Netsrot1150/esp32-outlander-bms/hw/fab/render_bottom.png

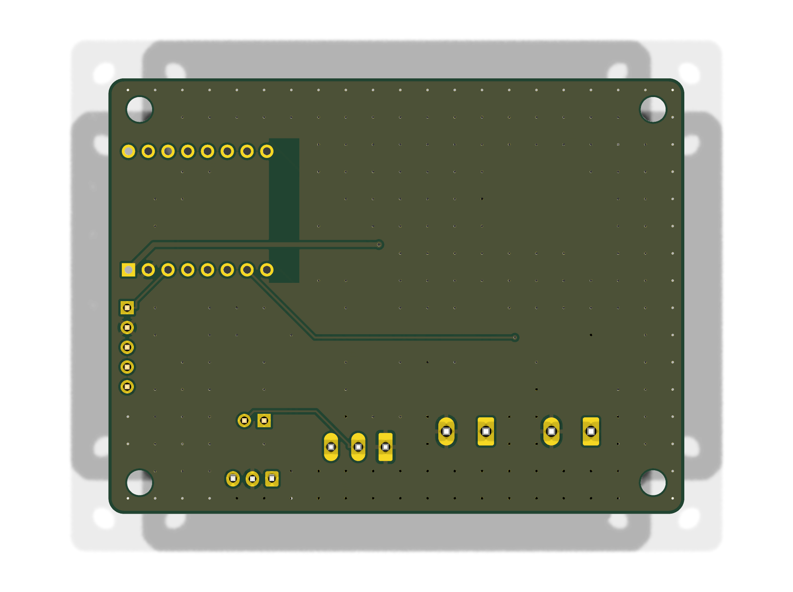
hw/fab/render_bottom.png
