Netsrot1150/esp32-outlander-bms/hw/fab/bms-kort-bom.csv

Comment | Designator | Footprint | LCSC
SN65HVD230 | U3 | SOIC-8_3.9x4.9mm_P1.27mm | C12084
10u 50V | C1 | C_1206_3216Metric | C13585
L78L33ACUTR | U2 | SOT-89-3 | C14170
NUP2105L | D4 | SOT-23 | C14486
100n | C2,C4,C8,C11,C12,C13 | C_0603_1608Metric | C14663
AO3401A | Q1,Q2 | SOT-23 | C15127
1u | C9,C10 | C_0603_1608Metric | C15849
2A 30V | F1 | Fuse_1812_4532Metric | C18198342
1k | R9,R12,R16 | R_0603_1608Metric | C21190
120 | R13 | R_0603_1608Metric | C22787
1M | R1,R5,R14 | R_0603_1608Metric | C22935
BMS | D3 | LED_0805_2012Metric | C2297
2M | R2 | R_0603_1608Metric | C22976
4.7k | R11 | R_0603_1608Metric | C23162
470k | R3 | R_0603_1608Metric | C23178
68k | R8 | R_0603_1608Metric | C23231
100k | R10 | R_0603_1608Metric | C25803
120k | R4,R6 | R_0603_1608Metric | C25808
200k | R15 | R_0603_1608Metric | C25811
47k | R7 | R_0603_1608Metric | C25819
SMBJ18A | D1 | D_SMB | C353379
22u 25V | C5,C6,C7 | C_0805_2012Metric | C45783
2.2u 50V | C3 | C_1206_3216Metric | C50254
TPS560430XDBVR | U1 | SOT-23-6 | C524782
22u | L1 | L_Sunlord_SWPA5040S | C68434
2N7002 | Q3 | SOT-23 | C8545
B5819W | D2,D5 | D_SOD-123 | C8598
