Netsrot1150/esp32-outlander-bms/hw/fab/handlodning.csv

Ref | Värde | LCSC | Del | Not
J1 | 12V IN | C441204 | KF2EDGR-5.08-2P | Plugg: KF2EDGK-5.08-2P (C440880)
J2 | CMU 12V | C441204 | KF2EDGR-5.08-2P | Plugg: KF2EDGK-5.08-2P (C440880)
J3 | CAN | C5160226 | 15EDGRC-3.5-03P | Plugg: 15EDGK-3.5-03P (C5188250)
J4 | WCS1700 | C144394 | B3B-XH-A | 1 = 3,3 V, 2 = GND, 3 = AO
JP1 | 120R | C492401 | PZ254V-11-02P | Bygel på = 120 Ω avslutning
U4 | ESP32-C3 SuperMini | C27438 | 2 st hylslist 1x8 2,54 mm 8,5 mm | Hylslisten (2 st C27438) löds på kortet. Ta bort röda ström-LED:en på SuperMini
