Netsrot1150/esp32-outlander-bms/hw/fab/bms-kort-schema.pdf

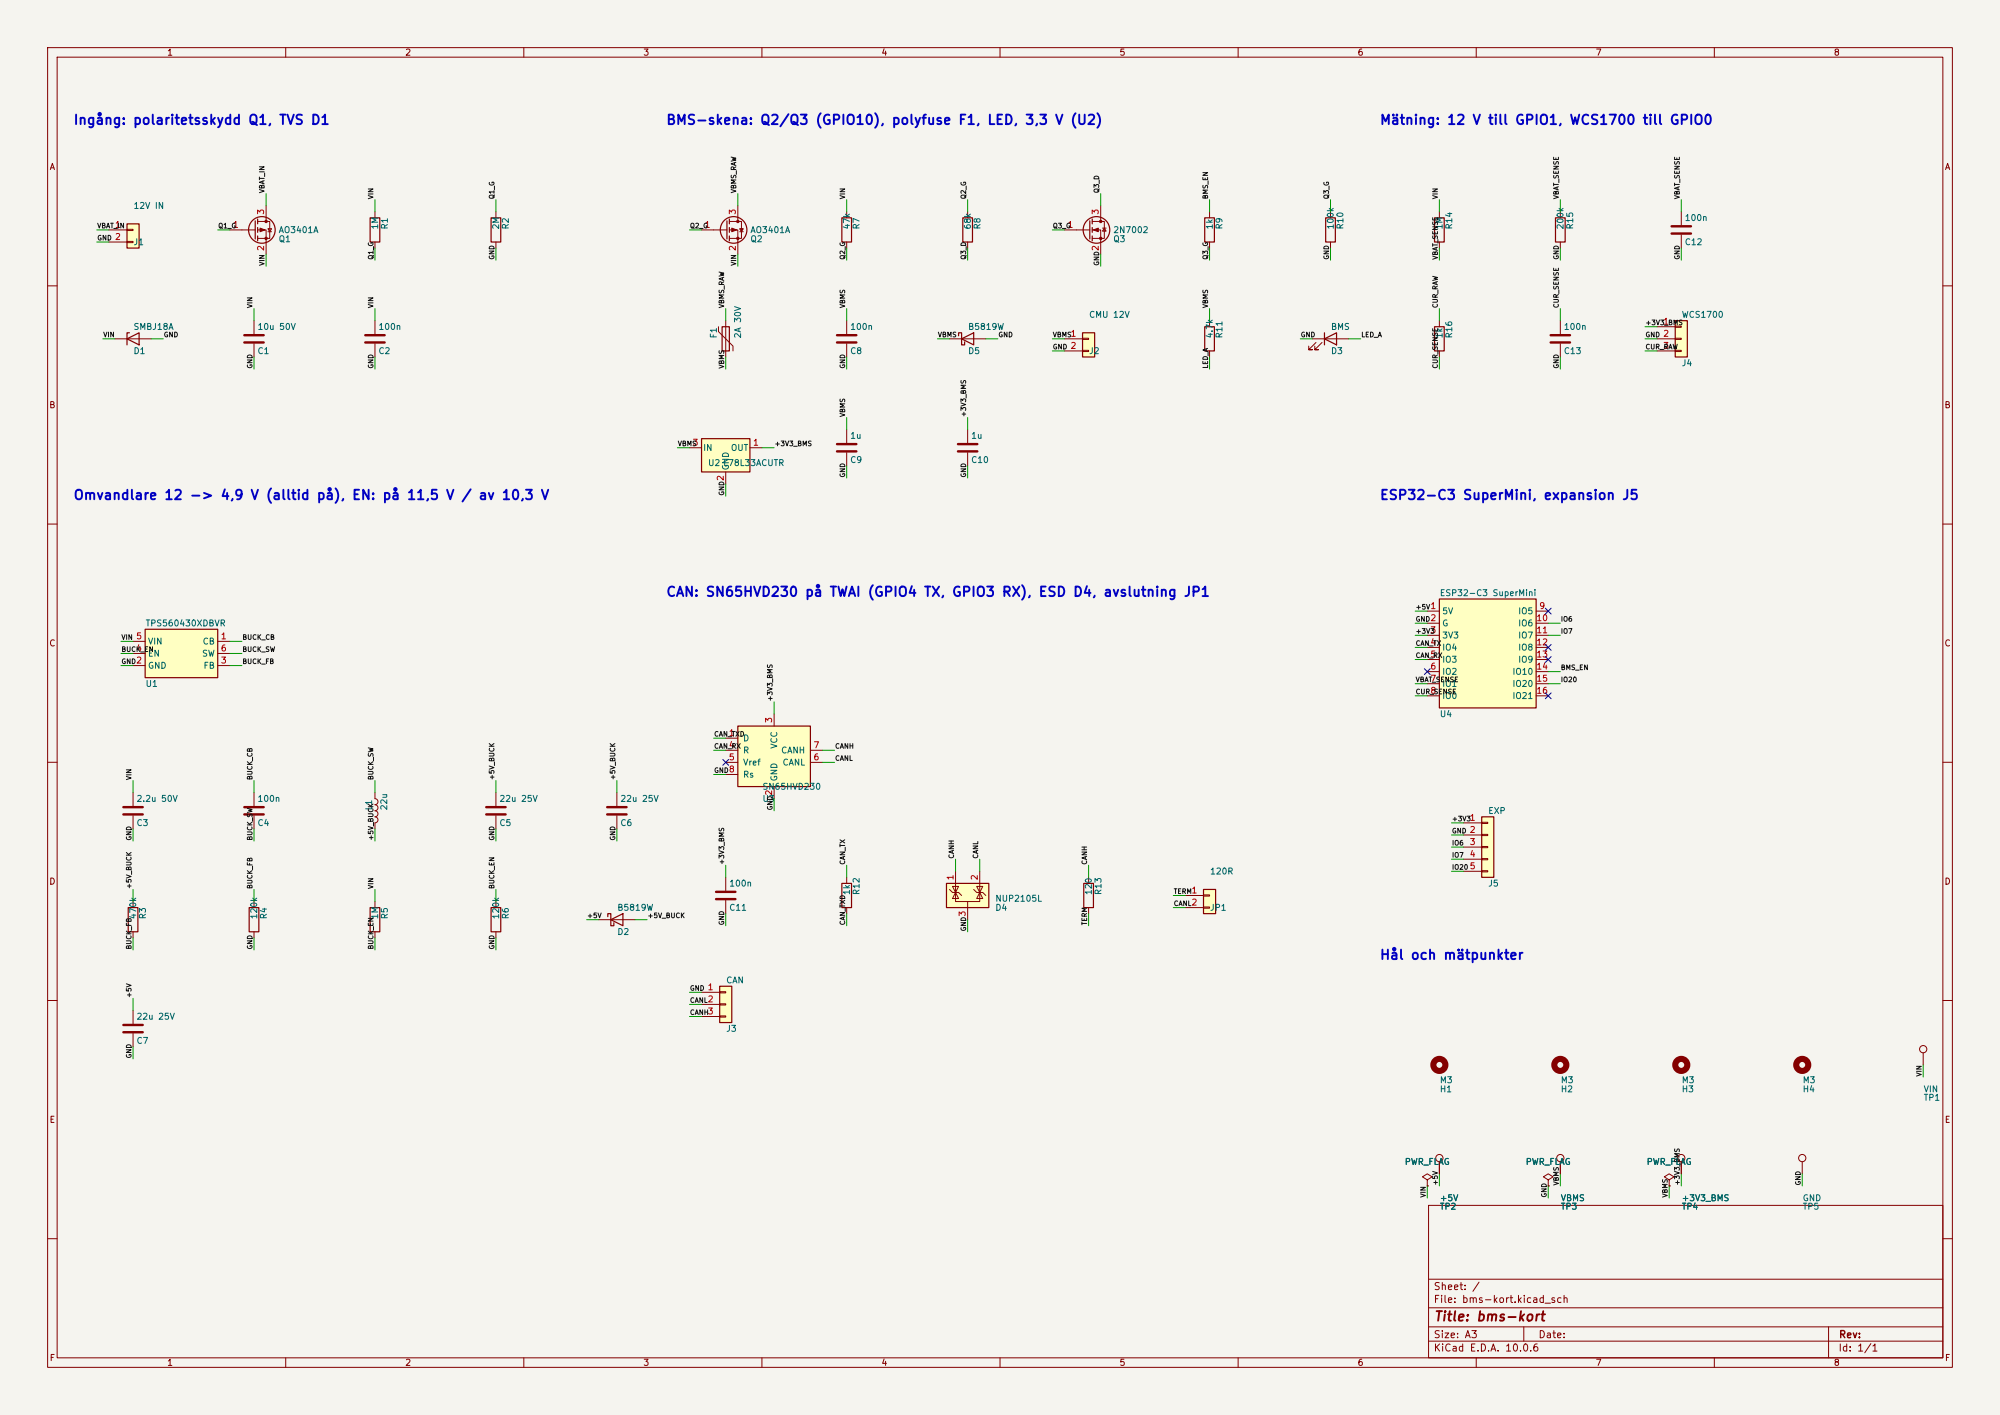
[picture p4: page 1]

Omvandlare 12 -> 4,9 V (alltid på), EN: på 11,5 V / av 10,3 V
BUCK_SW GND

CAN: SN65HVD230 på TWAI (GPIO4 TX, GPIO3 RX), ESD D4, avslutning JP1

Size: A3 | Rev: | F Date:
KiCad E.D.A. 10.0.6 | Id: 1/1
