Netsrot1150/esp32-outlander-bms/hw/bms-kort/bms-kort.kicad_pcb

## KiCad design hw/bms-kort/bms-kort.kicad_pcb (2026-10-15)

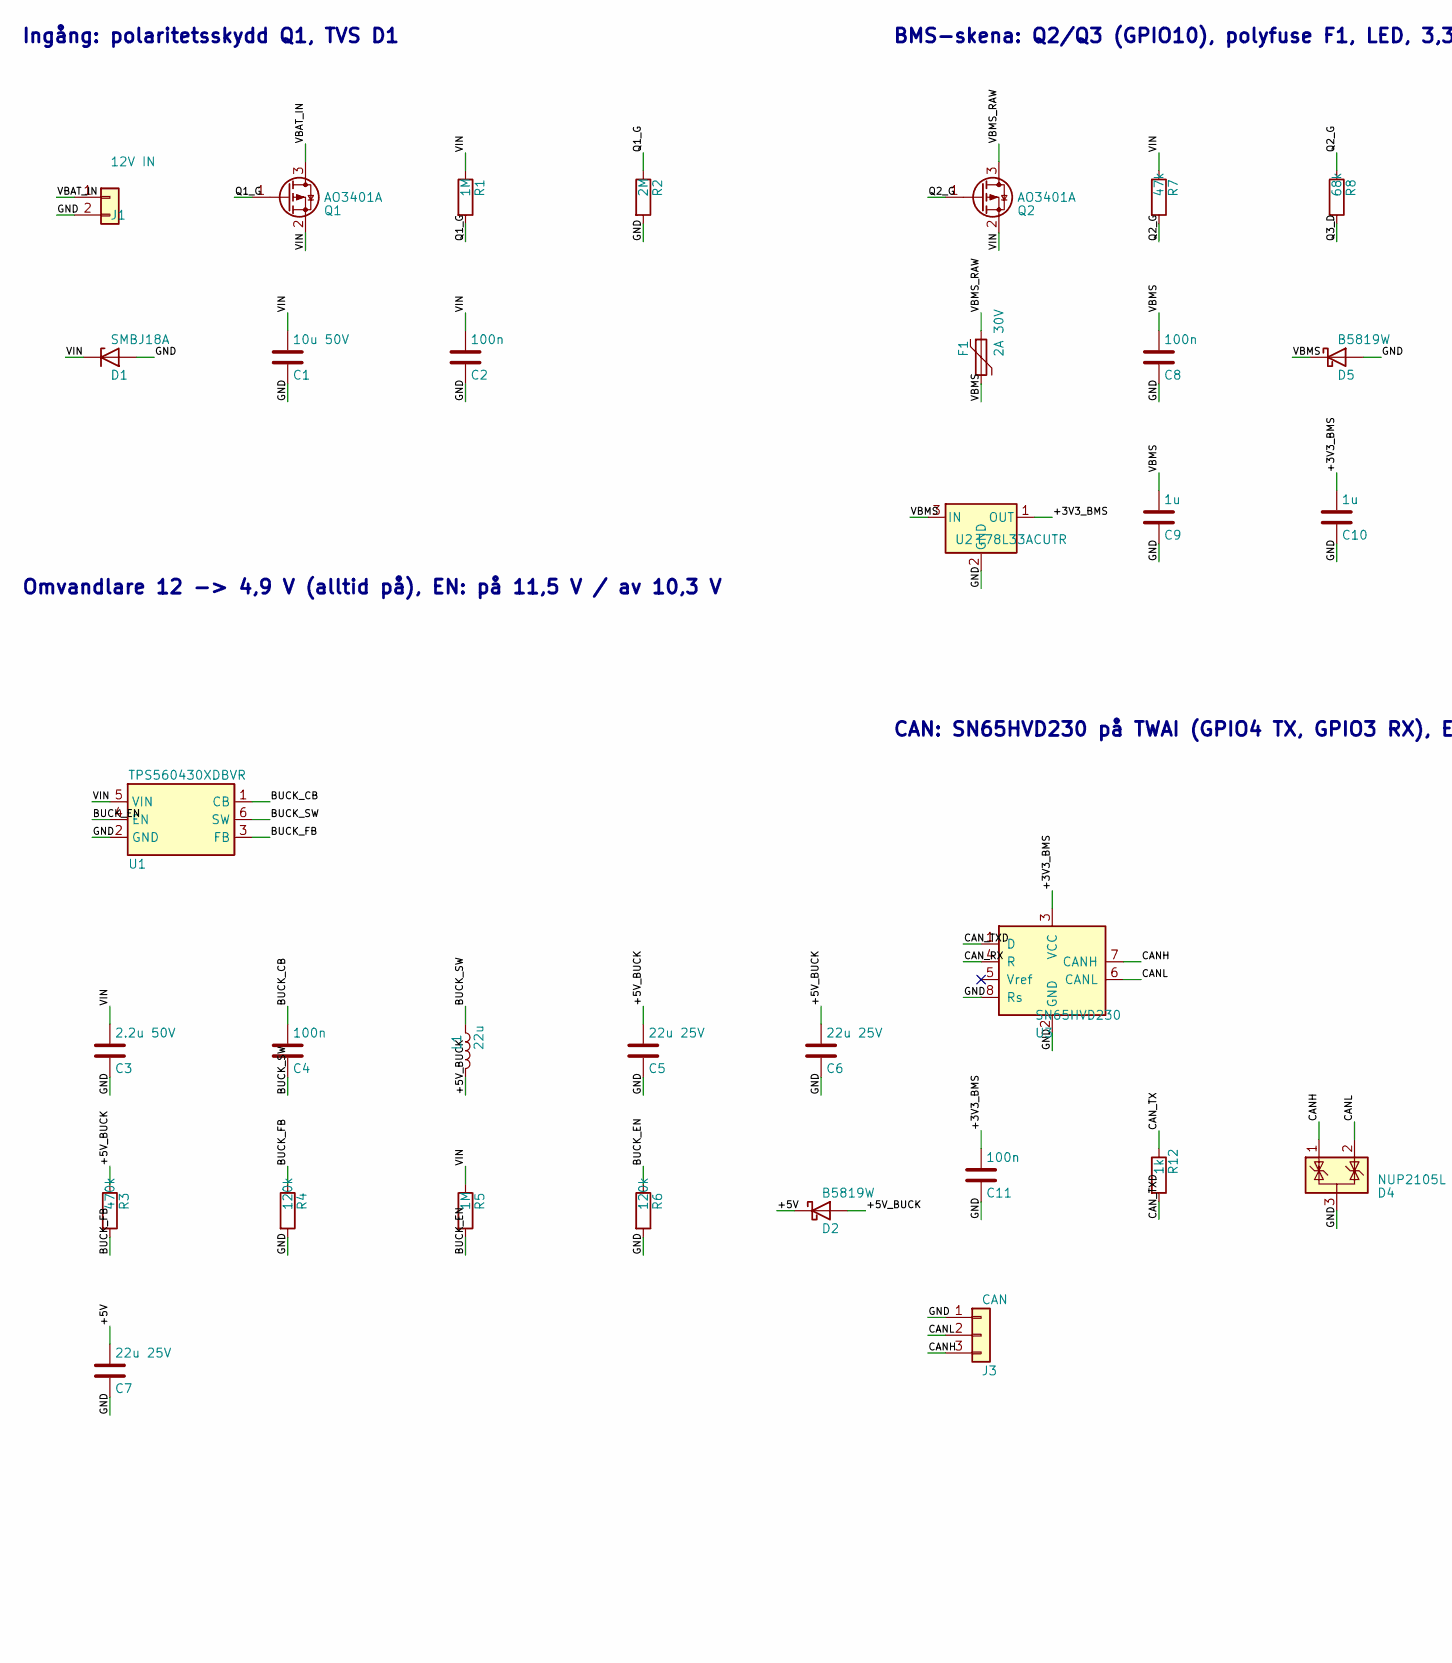
[picture p5: schematic bms-kort.kicad_sch, part in row 1, column 1]

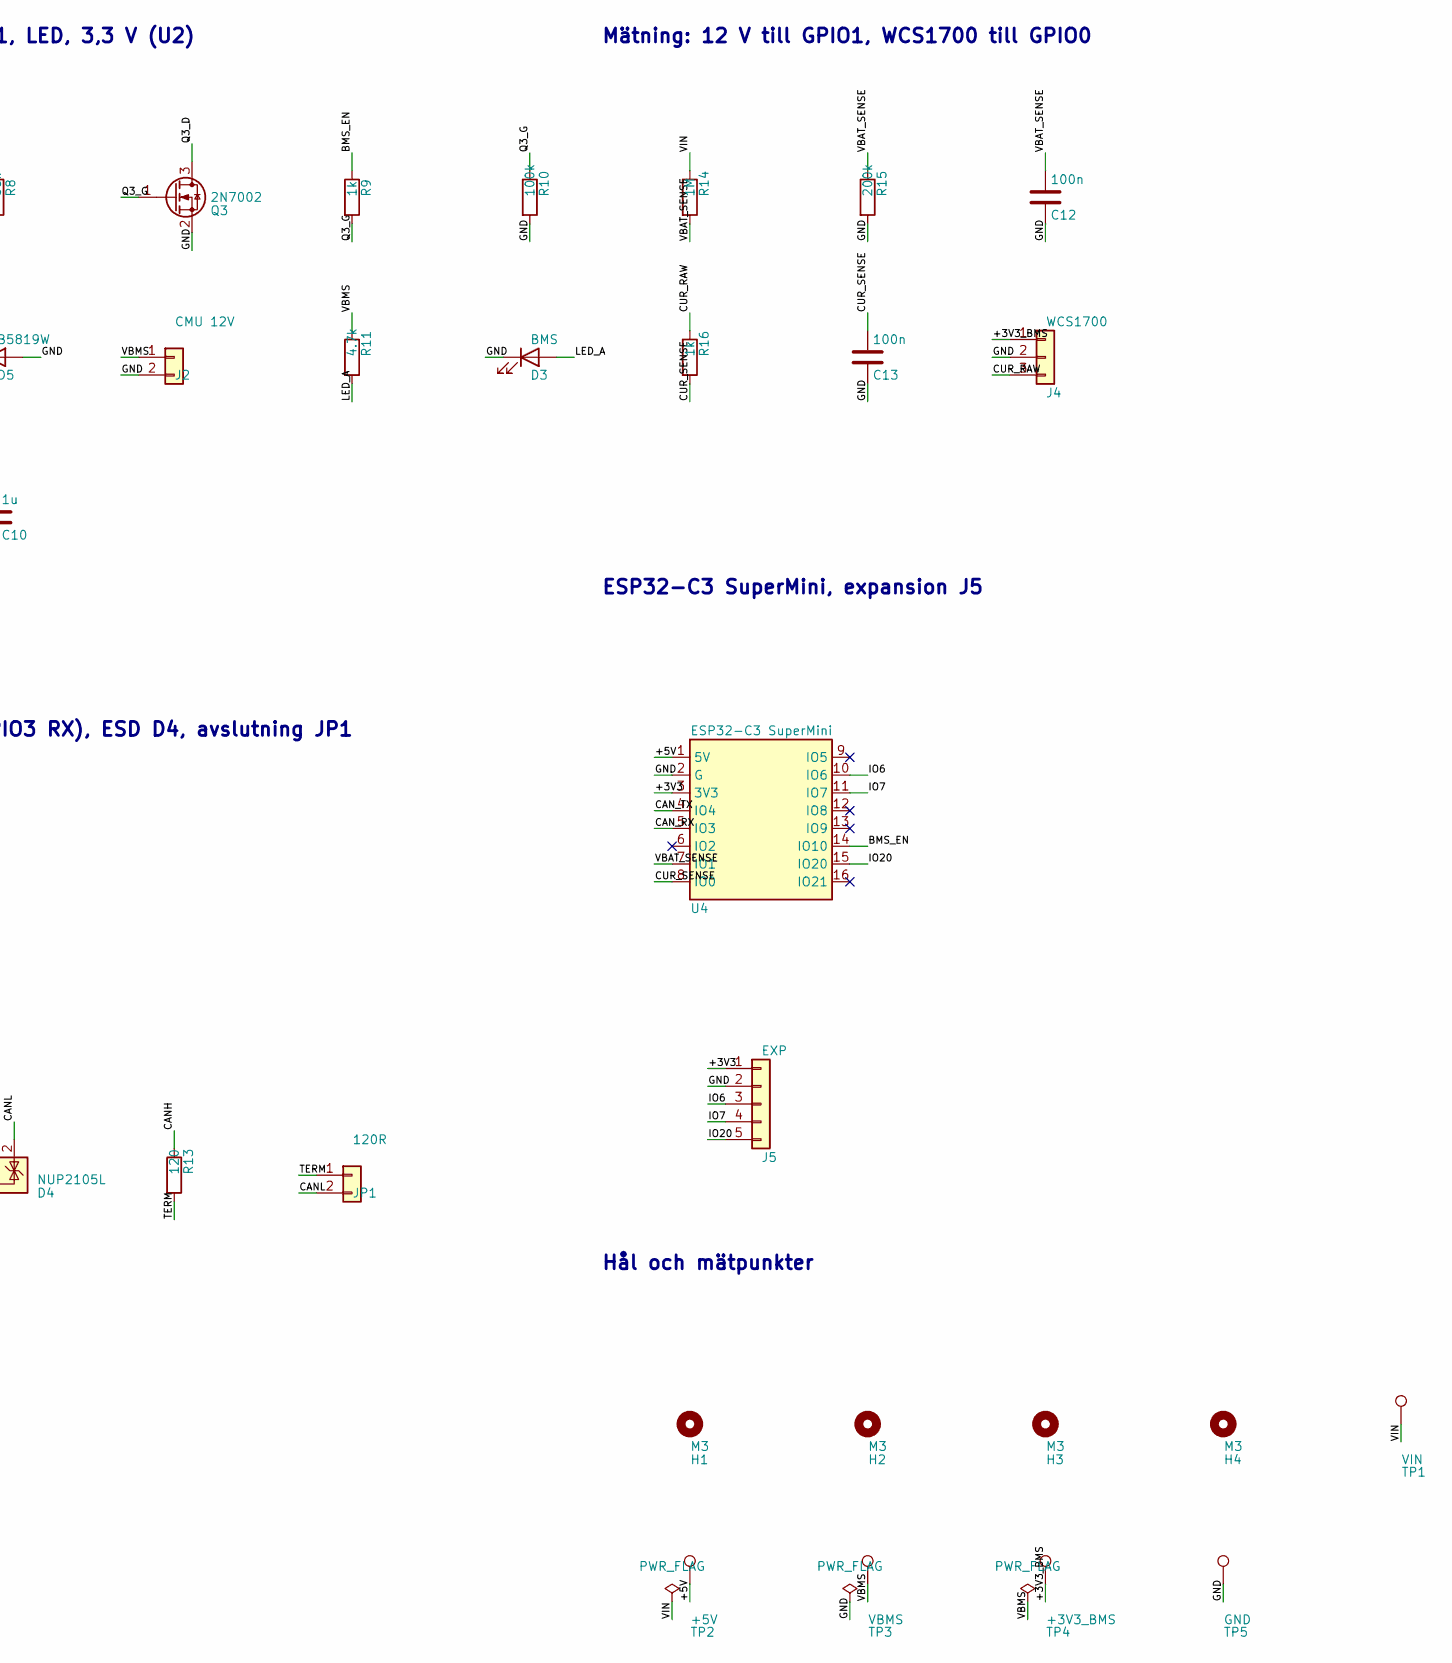
[picture p6: schematic bms-kort.kicad_sch, part in row 1, column 2]

Parts:
C1: 10u 50V; C_1206_3216Metric; LCSC C13585
C2, C4, C8, C11, C12, C13: 100n; C_0603_1608Metric; LCSC C14663
C3: 2.2u 50V; C_1206_3216Metric; LCSC C50254
C5, C6, C7: 22u 25V; C_0805_2012Metric; LCSC C45783
C9, C10: 1u; C_0603_1608Metric; LCSC C15849
D1: SMBJ18A; D_SMB; LCSC C353379
D2, D5: B5819W; D_SOD-123; LCSC C8598
D3: BMS; LED_0805_2012Metric; LCSC C2297
D4: NUP2105L; SOT-23; LCSC C14486
F1: 2A 30V; Fuse_1812_4532Metric; LCSC C18198342
H1, H2, H3, H4: M3; MountingHole_3.2mm_M3
J1: 12V IN; PhoenixContact_MSTBA_2,5_2-G-5,08_1x02_P5.08mm_Horizontal; LCSC C441204
J2: CMU 12V; PhoenixContact_MSTBA_2,5_2-G-5,08_1x02_P5.08mm_Horizontal; LCSC C441204
J3: CAN; PhoenixContact_MC_1,5_3-G-3.5_1x03_P3.50mm_Horizontal; LCSC C5160226
J4: WCS1700; JST_XH_B3B-XH-A_1x03_P2.50mm_Vertical; LCSC C144394
J5: EXP; PinHeader_1x05_P2.54mm_Vertical
JP1: 120R; PinHeader_1x02_P2.54mm_Vertical; LCSC C492401
L1: 22u; L_Sunlord_SWPA5040S; LCSC C68434
Q1, Q2: AO3401A; SOT-23; LCSC C15127
Q3: 2N7002; SOT-23; LCSC C8545
R1, R5, R14: 1M; R_0603_1608Metric; LCSC C22935
R2: 2M; R_0603_1608Metric; LCSC C22976
R3: 470k; R_0603_1608Metric; LCSC C23178
R4, R6: 120k; R_0603_1608Metric; LCSC C25808
R7: 47k; R_0603_1608Metric; LCSC C25819
R8: 68k; R_0603_1608Metric; LCSC C23231
R9, R12, R16: 1k; R_0603_1608Metric; LCSC C21190
R10: 100k; R_0603_1608Metric; LCSC C25803
R11: 4.7k; R_0603_1608Metric; LCSC C23162
R13: 120; R_0603_1608Metric; LCSC C22787
R15: 200k; R_0603_1608Metric; LCSC C25811
TP1: VIN; TestPoint_Pad_D1.5mm
TP2: +5V; TestPoint_Pad_D1.5mm
TP3: VBMS; TestPoint_Pad_D1.5mm
TP4: +3V3_BMS; TestPoint_Pad_D1.5mm
TP5: GND; TestPoint_Pad_D1.5mm
U1: TPS560430XDBVR; SOT-23-6; LCSC C524782
U2: L78L33ACUTR; SOT-89-3; LCSC C14170
U3: SN65HVD230; SOIC-8_3.9x4.9mm_P1.27mm; LCSC C12084
U4: ESP32-C3 SuperMini; ESP32C3_SuperMini_Socket; LCSC C27438

Connections:
+3V3: J5.1, U4.3 (3V3)
+3V3_BMS: C10.1, C11.1, J4.1, TP4.1, U2.1 (OUT), U3.3 (VCC)
+5V: C7.1, D2.1 (K), TP2.1, U4.1 (5V)
+5V_BUCK: C5.1, C6.1, D2.2 (A), L1.2, R3.1
BMS_EN: R9.1, U4.14 (IO10)
BUCK_CB: C4.1, U1.1 (CB)
BUCK_EN: R5.2, R6.1, U1.4 (EN)
BUCK_FB: R3.2, R4.1, U1.3 (FB)
BUCK_SW: C4.2, L1.1, U1.6 (SW)
CANH: D4.1 (K), J3.3, R13.1, U3.7 (CANH)
CANL: D4.2 (K), J3.2, JP1.2, U3.6 (CANL)
CAN_RX: U3.4 (R), U4.5 (IO3)
CAN_TX: R12.1, U4.4 (IO4)
CAN_TXD: R12.2, U3.1 (D)
CUR_RAW: J4.3, R16.1
CUR_SENSE: C13.1, R16.2, U4.8 (IO0)
GND: C1.2, C2.2, C3.2, C5.2, C6.2, C7.2, C8.2, C9.2, C10.2, C11.2, C12.2, C13.2, D1.2 (A), D3.1 (K), D4.3 (A), D5.2 (A), J1.2, J2.2, J3.1, J4.2, J5.2, Q3.2 (S), R2.2, R4.2, R6.2, R10.2, R15.2, TP5.1, U1.2 (GND), U2.2 (GND), U3.2 (GND), U3.8 (Rs), U4.2 (G)
IO6: J5.3, U4.10 (IO6)
IO7: J5.4, U4.11 (IO7)
IO20: J5.5, U4.15 (IO20)
LED_A: D3.2 (A), R11.2
Q1_G: Q1.1 (G), R1.2, R2.1
Q2_G: Q2.1 (G), R7.2, R8.1
Q3_D: Q3.3 (D), R8.2
Q3_G: Q3.1 (G), R9.2, R10.1
TERM: JP1.1, R13.2
VBAT_IN: J1.1, Q1.3 (D)
VBAT_SENSE: C12.1, R14.2, R15.1, U4.7 (IO1)
VBMS: C8.1, C9.1, D5.1 (K), F1.2, J2.1, R11.1, TP3.1, U2.3 (IN)
VBMS_RAW: F1.1, Q2.3 (D)
VIN: C1.1, C2.1, C3.1, D1.1 (K), Q1.2 (S), Q2.2 (S), R1.1, R5.1, R7.1, R14.1, TP1.1, U1.5 (VIN)

Notes on the sheet:
Ingång: polaritetsskydd Q1, TVS D1
Omvandlare 12 -> 4,9 V (alltid på), EN: på 11,5 V / av 10,3 V
BMS-skena: Q2/Q3 (GPIO10), polyfuse F1, LED, 3,3 V (U2)
CAN: SN65HVD230 på TWAI (GPIO4 TX, GPIO3 RX), ESD D4, avslutning JP1
Mätning: 12 V till GPIO1, WCS1700 till GPIO0
ESP32-C3 SuperMini, expansion J5
Hål och mätpunkter

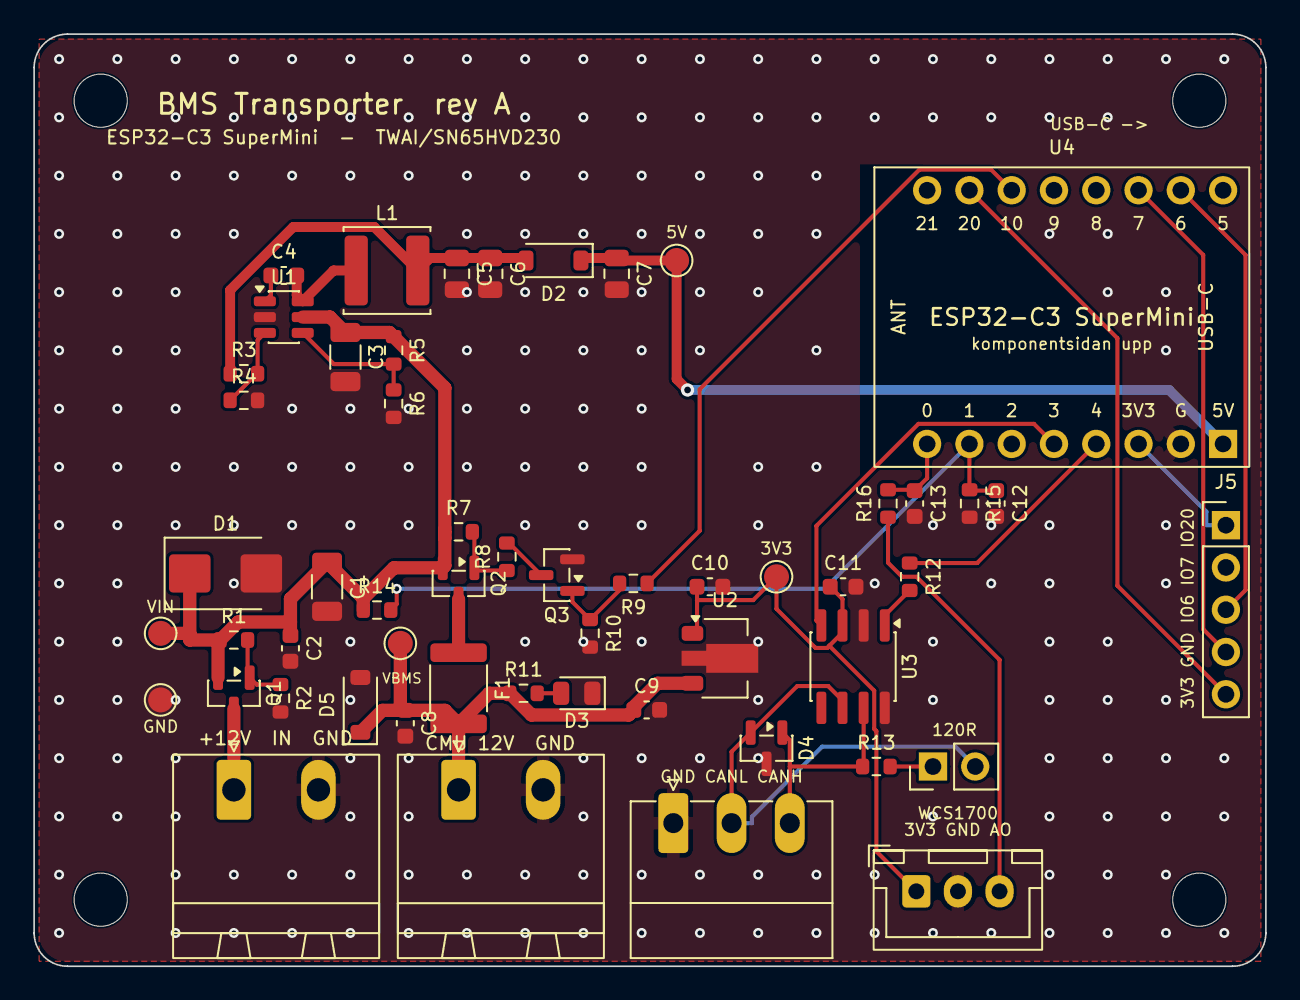
[picture p7: board bms-kort.kicad_pcb from above]

Board: 2 copper layers, 74.0 x 56.0 mm, 58 parts (0 on the bottom side), 31 nets.
