Netsrot1150/esp32-outlander-bms/BMS_v2/clock.h

#pragma once
// Klocka: NTP när hemnätet finns, annars tiden som webbläsaren skickar.
#include <stdint.h>

void clockBegin();
void clockLoop();                                // en gång per sekund
bool clockKnown();
uint32_t clockEpoch();                           // 0 om okänd
void clockSetEpoch(uint32_t epoch, bool fromNtp);
