Netsrot1150/esp32-outlander-bms/BMS_v2/secrets.example.h

#pragma once
// Mall. Kopiera till secrets.h och fyll i. secrets.h versionshanteras inte.
#define DEFAULT_AP_SSID  "BMS-Transporter"
#define DEFAULT_AP_PASS  "byt-detta-losen"   // eget WiFi, minst 8 tecken
#define DEFAULT_STA_SSID ""                  // hemnätets namn, tomt = inget hemnät
#define DEFAULT_STA_PASS ""
