Netsrot1150/esp32-outlander-bms/(commit log)

2026-10-06 Add tools/mock_server.py: preview the web UI on a PC without an ESP32
2026-10-15 Add carrier board rev A (KiCad, generated from Python)
    ESP32-C3 SuperMini carrier: always-on 5 V buck (TPS560430X, UVLO
    11.5/10.3 V), switchable CMU supply (P-FET, 2 A polyfuse), 12 V sense,
    CAN through the C3's TWAI and an SN65HVD230, WCS1700 input. Schematic,
    layout, routing (Freerouting) and JLCPCB files are generated by hw/gen;
    DRC, ERC and schematic parity are clean.
    [bms-kort-B_Cu.gbl, bms-kort-B_Mask.gbs, bms-kort-B_Paste.gbp, bms-kort-B_Silkscreen.gbo, bms-kort-Edge_Cuts.gm1, bms-kort-F_Cu.gtl, bms-kort-F_Mask.gts, bms-kort-F_Paste.gtp]
